li59533/RoadRollerSensor/doc/压路机通讯协议说明.md

# LN 压路机传感器通讯协议说明
V0.0.4

日期：2020.9.7

## 1.采用协议
LN私有协议 + 上报私有协议 
###  1.1 协议格式
**LN协议格式**

```
// head len cmd tlv foot sum
typedef struct
{
    uint8_t head;
    uint16_t len;
    uint16_t inf
    uint8_t cmd;
    uint8_t * payload;
    uint8_t foot;
    uint8_t sum;
}LN_Protocol_t
```
**上报私有协议**
```c
typedef struct
{
    uint8_t head;
    uint8_t type;
    uint16_t len;
    float acc_uppeak;
	float base_frequency;
	float harmonic_peak_0_5;
	float harmonic_peak_1;
	float harmonic_peak_1_5;
	float harmonic_peak_2;
	float harmonic_peak_2_5;
	float harmonic_peak_3;
	float harmonic_peak_4;
	float harmonic_peak_5;
	float harmonic_peak_6;
	float speed_RMS;
	float displace_uppeak;
	float temperature;
	uint8_t power;
    float acc_mean;
	float acc_downpeak;
    float displace_downpeak;
	uint8_t sum;
	uint8_t foot;
}

```

### 1.2协议说明
	**LN 协议**
* head ： 协议头部，为固定标识
* len :从head到sum的长度
* Inf:预留，用于兼容点对点、1对多、ACK等用途
* cmd：当前报文所属命令
* payload：当前cmd所包含的负载内容
* foot: 协议尾部，为固定标识
* sum:校验和，从head到foot
  **上报协议**
* head：协议头部，为固定标识
* type：类型
* len：长度，以下数据的所有长度，从acc_uppeak到displace_downpeak
* acc_uppeak：加速度正峰值，g
* base_frequency：基频，Hz
* harmonic_peak_0_5：0.5次谐波峰值，g
* harmonic_peak_1：1次谐波峰值，g
* harmonic_peak_1_5：1.5次谐波峰值，g
* harmonic_peak_2：2次谐波峰值，g
* harmonic_peak_2_5：2.5次谐波峰值，g
* harmonic_peak_3：3次谐波峰值，g
* harmonic_peak_4：4次谐波峰值，g
* harmonic_peak_5：5次谐波峰值，g
* harmonic_peak_6：6次谐波峰值，g
* speed_RMS：速度有效值，mm/s
* displace_uppeak：位移正峰值，um
* temperature：温度，C
* power：电量
* acc_mean：加速度均值，g
* acc_downpeak：加速度负峰值，g
* displace_downpeak：位移负峰值，um
* sum：校验和，从type到校验和之前
* foot：协议尾部，为固定值
## 2.命令说明
### 2.1 压路机支持命令
|序号|cmd|说明|名称|
|---|---|---|---|
|1|0x01|设置配置参数 请求|CMD_SetConf_Req|
|2|0x02|设置配置参数 应答|CMD_SetConf_Resp|
|3|0x03|获取配置参数 请求|CMD_GetConf_Req|
|4|0x04|获取配置参数 应答|CMD_GetConf_Resp|
|5|0x80|获取软件版本 请求|CMD_GetVersion_Req|
|6|0x81|获取软件版本 应答|CMD_GetVersion_Resp|
|7|0xD0|获取数据 请求|CMD_GetValue_Req|
| | | | |

### 2.2 CMD说明

#### 2.2.1 设置配置参数
**请求**：CMD-> CMD_SetConf_Req (0x01)
**Payload **：TLV
协议如下：

|序号|Tag|Len|Value|说明|
|---|---|---|---|---|
|1|0x44|4||电压与加速度对应关系，float 类型。eg:500mv/g|
|2|0x45|1|0-1|自动上报数据标志，0：停用，1：启用|
|3|0x46|1|0~250|位移频率区间_Low 默认10|
|4|0x47|1|0~250|位移频率区间_High 默认 60|
| | | | ||
**应答**
无

#### 2.2.2 获取配置参数

**请求**：CMD->CMD_GetConf_Req(0x03)
**Payload **：

无

**应答**
**Payload **：TLV
协议如下：

|序号|Tag|Len|Value|说明|
|---|---|---|---|---|
|1|0x44|4||电压与加速度对应关系，float 类型。eg:500mv/g|
|2|0x45|1|0-1|自动上报数据标志，0：停用，1：启用|
|3|0x46|1|0~250|位移频率区间_Low|
|4|0x47|1|0~250|位移频率区间_High|
||||||
#### 2.2.3 获取软件版本
**请求**：CMD->CMD_GetVersion_Req(0x80)
**Payload **：

无

**应答**
**Payload**:

```
typedef struct
{
    uint32_t version;
}Payload_t
```

uint32_t 为小端

0x00010203 为1.2.3版本

#### 2.2.4 获取数据
**请求**：CMD->CMD_GetValue_Req(0xD0)
**Payload **：

无

**应答**
**上报私有协议**:type:0x42
