li59533/RoadRollerSensor/doc/压路机传感器测试报告_20191023.xlsx

测试报告
产品名称 |  | 产品编号
软件版本 | V1.0.0 | 硬件版本
测试人员 | 李阳 | 测试时间 | 2019-10-23
测试内容
序号 | 内容 | 状态 | 说明
1 | 不插振动传感器，上报数据清零，传感器指示灯灭 | 通过 | 数据见附录1
2 | 传感器短路，上报数据清零，传感器指示灯快速闪烁 | 通过 | 数据见附录2
3 | 不插温度传感器，温度显示0，温度指示灯灭 | 通过 | 数据见附录3
4 | 振动台加速峰值1.02g，频率160HZ，速度有效值：7.067mm/s，位移峰值9.996m | 通过 | 数据见附录4
5 | 振动台加速峰值1.02g，频率80HZ，速度有效值：14.134mm/s，位移峰值39.984m | 通过 | 数据见附录5
6 | 振动台加速峰值1.02g，频率40HZ，速度有效值：28.268mm/s，位移峰值159.936m | 通过 | 数据见附录6
7 | 振动台加速峰值1.02g，频率20HZ，速度有效值：56.536mm/s，位移峰值639.744m | 不通过 | 振动台达不到20HZ
8 | 函数发生器1Vpp，频率160HZ，加速度峰值1g，速度有效值6.9286mm/s，位移峰值9.8m | 通过 | 数据见附录7
9 | 函数发生器1Vpp，频率80HZ，加速度峰值1g，速度有效值13.8572mm/s，位移峰值39.2m | 通过 | 数据见附录8
10 | 函数发生器1Vpp，频率40HZ，加速度峰值1g，速度有效值27.7144mm/s，位移峰值156.8m | 通过 | 数据见附录9
11 | 函数发生器1Vpp，频率20HZ，加速度峰值1g，速度有效值55.4288mm/s，位移峰值627.2m | 通过 | 数据见附录10
12 | 函数发生器1Vpp，频率10HZ，加速度峰值1g，速度有效值110.8576mm/s，位移峰值2508.8m | 不通过 | 位移峰值10HZ以下被清零了，数据见附录11
13 | 函数发生器1Vpp，频率5HZ，加速度峰值1g，速度有效值221.7152mm/s，位移峰值10035.2m | 不通过 | 位移峰值10HZ以下被清零了，数据见附录12
14 | 函数发生器1Vpp，频率200HZ，加速度峰值1g，速度有效值5.5428mm/s，速度峰值6.272m |  | 数据见附录14
15
16
17
18
19
测试结论
内容 | 1、信号幅值有10%的衰减 2、位移在10HZ以下，没开矩形窗处理掉了 3、速度有效值与加速度峰值满足对应关系 4、位移峰值在11HZ到199HZ ,基本满足与加速度峰值的对应关系
测试是否通过
