li59533/RoadRollerSensor/Master_firmware/changelog.md

-----------------------
**发布时间：**2020.9.11
**代码地址：**https://github.com/li59533/RoadRollerSensor.git
**版本：**V1.2.0
**说明：**
		1.默认参数：50mv/g
		2.加速度峰值单位：g
		3.速度有效值：mm/s
		4.位移峰值；um

**更新内容：**

_删除：_
		无
_新增：_
		无
_修改：_
		1.均值修改为绝对值均值

-----------------
-----------------------
**发布时间：**2020.9.4
**代码地址：**https://github.com/li59533/RoadRollerSensor.git
**版本：**V1.1.5
**说明：**
		1.默认参数：50mv/g
		2.加速度峰值单位：g
		3.速度有效值：mm/s
		4.位移峰值；um

**更新内容：**

_删除：_
		无
_新增：_
		无
_修改：_
		1.默认dis_freq_low:10 , high:60

-----------------

-----------------------
**发布时间：**2020.9.4
**代码地址：**https://github.com/li59533/RoadRollerSensor.git
**版本：**V1.1.4
**说明：**
		1.默认参数：50mv/g
		2.加速度峰值单位：g
		3.速度有效值：mm/s
		4.位移峰值；um

**更新内容：**

_删除：_
		无
_新增：_
		无
_修改：_
		1.取Ac负峰值、均值
        2.取1~200的最大基频
        3.谐波取区间最大值+-2
        4.位移频率截断可配置
        5.

-----------------
-----------------------
-----------------------
**发布时间：**2020.5.6
**代码地址：**https://github.com/li59533/RoadRollerSensor.git
**版本：**V1.1.2
**说明：**
		1.默认参数：500mv/g
		2.加速度峰值单位：g
		3.速度有效值：mm/s
		4.位移峰值；m

**更新内容：**

_删除：_
		1.删除温度+3操作
_新增：_
		无
_修改：_
		1.默认主动上报模式

-----------------
-----------------------
**发布时间：**2020.4.23
**代码地址：**https://github.com/li59533/RoadRollerSensor.git
**版本：**V1.1.1
**说明：**
		1.默认参数：500mv/g
		2.加速度峰值单位：g
		3.速度有效值：mm/s
		4.位移峰值；m

**更新内容：**

_删除：_
		无
_新增：_
		无
_修改：_
		1.修改fft积分函数

-----------------
-----------------------
**发布时间：**2020.1.2
**代码地址：**https://github.com/li59533/RoadRollerSensor.git
**版本：**V1.1.0
**说明：**
		1.默认参数：500mv/g
		2.加速度峰值单位：g
		3.速度有效值：mm/s
		4.位移峰值；m

**更新内容：**

_删除：_
		无
_新增：_
		1.增加自动上报数据标志位
		2.增加被动请求主句命令
_修改：_
		无

-----------------

-----------------------
**发布时间：**2019.10.23
**代码地址：**https://github.com/li59533/RoadRollerSensor.git
**版本：**V1.0.0
**说明：**
		1.默认参数：500mv/g
		2.加速度峰值单位：g
		3.速度有效值：mm/s
		4.位移峰值；m

**更新内容：**

_删除：_
		无
_新增：_
		无
_修改：_

		1.速度有效值替换速度峰值。但是为mm/s

-----------------

-----------------------
**发布时间：**2019.10.22
**代码地址：**https://github.com/li59533/RoadRollerSensor.git
**版本：**V0.1.1
**说明：**
		1.默认参数：500mv/g
		2.加速度单位：g
		3.速度：m/s
		4.位移；m

**更新内容：**

_删除：_
		无
_新增：_
		1.增加Hanning窗
		2.增加0Hz判断清零
_修改：_

		无

-----------------

-----------------------
**发布时间：**2019.10.17
**代码地址：**https://github.com/li59533/RoadRollerSensor.git
**版本：**V0.1.0
**说明：**

		首次提交。

**更新内容：**

		无

_删除：_
		无
_新增：_
		无
_修改：_

		无

-----------------
