li59533/RoadRollerSensor/doc/压实采集器.pdf

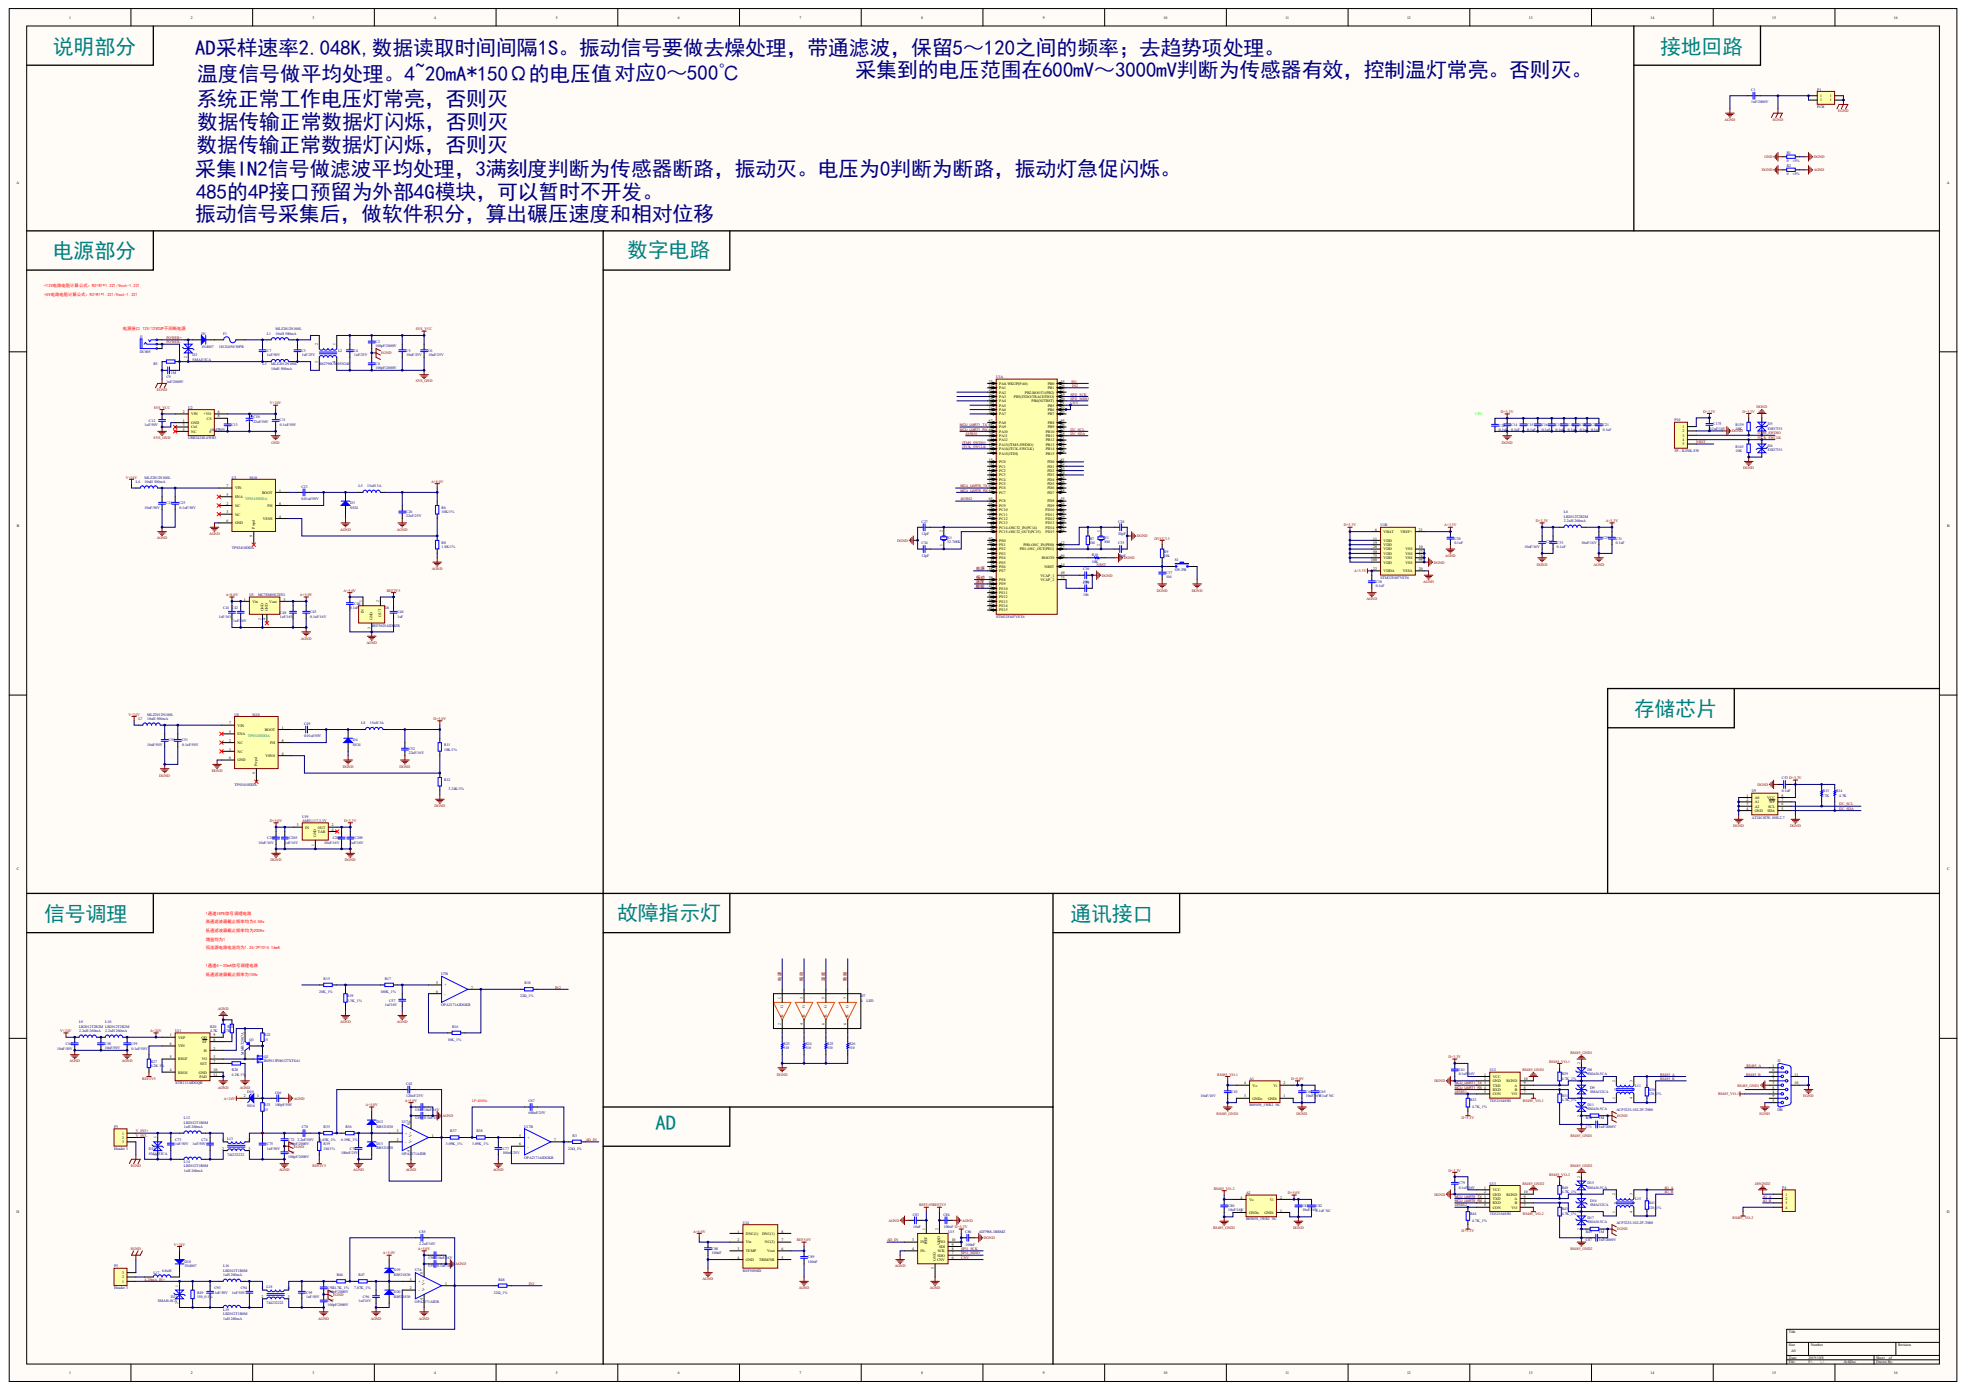
[picture p8: page 1]

GND 6 | AGND

GND 5 CNV 6 SDO 7 SCK 8 SDI 9 VIO 10

Comment | Description | Designator | Footprint | LibRef | Quantity
1nF/ 2000V | 1nF_NPO_10%_2K V_1210, 1nF_X5R_10%_200 0V_1210 | C1, C71, C87 | C 1210_L | Cap | | 3
100pF/ 2000V | 100PF_X5R_10%_ 2000V_1206 | C2, C8 | C 1206_L | Cap | | 2
1uF/ 25V | 1uF_X5R_10%_25 V_0805 | C3, C4 | C 0805_L | Cap | | 2
10uF/ 25V | 10uF_X5R_10%_25 V_1210 | C5, C6 | C 1210_L | Cap | | 2
1uF/ 50V | 1uF_X5R_10%_50 V_0805 | C7, C12 | C 0805_L | Cap | | 2
1nF/ 2000V | 1nF_X5R_10%_200 0V_1206 | C9 | C 1206_L | Cap | | 1
22uF/ 50V | 铝电解电容 8*10.5 | C10 | CAP6.3 | Cap Pol1 | | 1
0.1uF/ 50V | 0.1uF_X5R_10%_5 0V_0603, 0.1uF_X5R_10%_5 0V_0805, 10uF_X5R_10%_50 V_0603 | C11, C25, C51, C59 | C 0603_L | Cap | | 4
10uF/ 50V | 10uF_X5R_10%_50 V_1210 | C13 | C 1210_L | Cap | | 1
0.1uF | 0.1uF_X5R_10%_1 6V_0603, 104_X7R_10%_16 V_0603 | C14, C15, C16, C17, C18, C19, C20, C21, C22, C30, C31, C33, C38, C40, C53 | C 0603_L | Cap | 15
0.01uf/50V | 0.01uF_X5R_10%_ 50V_0603 | C23, C49 | C 0603_L | Cap | | 2
10uF/ 50V | 10uF_X5R_10%_50 V_0603 | C24, C50 | C 0603_L | Cap | | 2
22uF/ 25V | 22uF_X5R_20%_25 V_0805 | C26 | C 0805_L | Cap | | 1
12pF | 12pF_X7R_10%_16 V_0603 | C27, C34 | C 0603_L | Cap | | 2
20pF | 20pF_X7R_10%_16 V_0603 | C28, C35 | C 0603_L | Cap | | 2
10uF/ 16V | 10uF_X5R_10%_16 V_0603 | C29, C32 | C 0603_L | Cap | | 2
100nF | 100nF_X7R_10%_1 6V_0603 | C36, C39, C84, C86, C88, C89 | C 0603_L | Cap | | 6
104 | 104_X7R_10%_16 V_0603 | C37 | C 0603_L | Cap | | 1
1uF/ 16V | 1uF_X5R_10%_16 V_0805 | C41, C42, C48 | C 0805_L | Cap | | 3
0.1uF/ 16V | 0.1uF_X5R_10%_1 6V_0603 | C45, C61, C69, C79, C91 | C 0603_L | Cap | | 5
1uF | 1uF_X5R_10%_16 V_0603 | C46 | C 0603_L | Cap | | 1
22uF/ 16V | 22uF_X5R_10%_16 V_0805 | C52 | C 0805_L | Cap | | 1
1uf/16V | 1UF_X7R_10%_16 V_0603, 1UFF_X7R_10%_5 0V_0603 | C57, C96 | C 0603_L | Cap | | 2
10uF/ 50V | 10uF_X5R_10%_50 V_0805 | C58, C60 | C 0805_L | Cap | | 2
120nF/ 25V | 12nF_X7R_10%_50 V_0603 | C62 | C 0603_L | Cap | | 1
10uF/ 16V | 10uF_X5R_10%_16 V_0805, 贴片电容 0805 | C63, C64, C80, C81, C207, C208 | 0805C | Cap | | 6
0.1uF NC | 0.1uF_X5R_10%_1 6V_0603 | C65, C82 | C 0603_L | CAP | | 2
100pF/ 50V | 0.1uF_X5R_10%_5 0V_0603 | C66 | C 0603_L | Cap | | 1
680nF/ 25V | 680nF_X7R_10%_2 5V_0603 | C67 | C 0603_L | Cap | | 1
10uF/ 16V | 10uF_X5R_10%_16 V_0805 | C68, C90 | C 0805_L | Cap | | 2
2.2uF/ 50V | 2.2uF_NPO_10%_5 0V_0805 | C70 | C 0805_L | Cap | | 1
100pF/ 2000V | 100pF_NPO_10%_ 2KV_1210 | C72, C78, C92, C97 | C 1210_L | Cap | | 4
1nF/ 50V | 1nF_X7R_10%_50 V_0603 | C73, C74, C75, C93, C94, C95 | C 0603_L | Cap | | 6
100nF/ 25V | 100nF_X7R_10%_2 5V_0603, 100nF_X7R_10%_5 0V_0603 | C76, C77 | C 0603_L | Cap | | 2
10uf | 10uF_X7R_10%_16 V_0603 | C83 | C 0603_L | Cap | | 1
2.2uF/ 16V | 2.2uF_X7R_10%_1 6V_0603 | C85 | C 0603_L | Cap | | 1
0.1uF/ 16V | 贴片电容 0603 | C175 | 0603C | Cap | | 1
1uF/ 16V | 贴片电容 0805 | C205, C209 | 0805C | Cap | | 2
1N4007 | 贴片二极管 | D1 | SMA | Diode 1N4007 | | 1
SMAJ13CA | 瞬态抑制二极管 | D2 | SMA | ESD_D | | 1
SS34 | _SMB(DO-214AA) 肖特基二极管 | D3, D4 | SMB | Diode 1N4007 | | 2
ESD7351 | 瞬态抑制二极管 | D5, D6 | SOD-323 | ESD_D | | 2
4 LED 联 | 90 LED ° 导光柱 4PIN 导光柱 型号 LPE4-5-16 | D7 | 4LED | 4 LED 联 | | 1
SMAJ6.5CA | 瞬态抑制二极管 | D8, D11, D15, D17 | SMA | ESD_D | | 4
SMAJ12CA | 瞬态抑制二极管 | D9, D16 | SMA | ESD_D | | 2
SS16 | 肖特基二极管 | D10 | SMA | D Zener | | 1
RB521S30 | 肖特基二极管 | D12, D13, D19, D20 | SOD-523 | DIODE | | 4
SMAJ33CA | 瞬态抑制二极管 | D14 | SMA | ESD_D | | 1
1N4007 | 二极管 | D18 | SMB | Diode 1N4007 | | 1
SMAJ6.0CA | 瞬态抑制二极管 | D21 | SMA | ESD_D | | 1
1812L050/ 30PR | 1812 30V 0.5A 贴片自恢复保险丝 | F1 | FU 1812 | Fuse 2 | | 1
DC005 | Jack SoDC 白 插座 DC005 5.5*2.1MM 3 3P 脚 DIP DC 电源接口 | J1 | DC-005 | Phonejack3 | | 1
DB 公头 | Receptacle Assembly, 9 Position, Right Angle | J2 | DB9/ P_A | D Connector 9 | | 1
MLZ2012N100L | 固定电感器 _20%_MLZ2012N1 _10uH_ 00LT000 | L1, L3, L4, L7 | L 0805 | Inductor | | 4
B82790C0105N240 | EPCOS, 扼流 圈 ,1mH,500mA | L2 | IND0163-B | TRAN | | 1
15uH 3A | _NR6028 6*6 功率电感 | L5, L8 | NR6028 | Inductor | | 2
LB2012T2R2M | 固定电感器 0805 | L6, L9, L10 | L 0805 | Inductor | | 3
ACP3225-102-2P-T000 | TDK, ,4.1uH,1.5A 共模扼流 圈 | L11, L15 | ACP3225 | TRANS1 | | 2
LB2012T1R0M | Taiyo Yuden 1uH 260mA | L12, L14, L16, L19 | L 0805 | Inductor | | 4
744232222 | 共模扼流圈 滤波器 / 2.2k 100MHz 200mA | L13, L18 | 744232222 | TRANS4_2 | | 2
6.8uH | 功率电感 _5.0*5.0*4.0_CKCS 5040-6.8uH/M | L17 | NR5040 | INDUCTOR | | 1
PCB 接地柱 | 接地座黄接线柱 M3M4 侧卧式 PCB 焊 接端子 pcb-2 | P1 | PCB 接地柱 | Header 2X2 | | 1
Header 3 | 插拔式 PCB 接线端 子 KF 2EDGV-3.81mm 直针座 3p | P3, P5 | KF-3.81-3P | Header 3 | | 2
科发接插件 | lZ1R-3.81-4P-140-00A 弯针加插头 | P4 | KF-3.81-4P | Header 4 | | 1
5P - JLINK-SW | Header, 5-Pin | P10 | HDR2.54-LI-5P | Header 5 | | 1
MMBT2907A | 三极管 PNP | Q1 | MMBT2907A | 2N3906 | | 1
BSP613PH6327XT SA1 | P-Channel MOSFET | Q2 | BSP613PH6327XT SA1 | MOSFET-P | | 1
0 ± 5% | 0 ± 5%_0603 | R1, R2 | 1206R | Res2 | | 2
Ω 22 _1% | Ω 22 _1%_0603 | R3, R18, R48 | 0603R | Res2 | | 3
1M | 1M_5%_0805 | R5, R34, R45 | 0805R | Res2 | | 3
10K/ 1% | 10K/ 1%_0603 | R6, R11 | 0603R | Res | | 2
1M | Resistor | R7 | 0603R | Res2 | | 1
1.8K/ 1% | 1.8K/ 1%_0603 | R8 | 0603R | Res | | 1
10k | 10K_1%_0603, Resistor, 贴片电阻 0603 | R9, R10, R139, R145 | 0603R | Res1, Res2 | | 4
3.24K/ 1% | 3.24K/ 1%_0603 | R12 | 0603R | Res | | 1
4.7k | 4.7k_1%_0603 | R13, R14 | 0603R | Res1 | | 2
20K_1% | 20K_1%_0603 | R15 | 0603R | Res2 | | 1
10K_1% | 10K_1%_0603 | R16 | 0603R | Res2 | | 1
100K_1% | 100K_1%_0603 | R17 | 0603R | Res2 | | 1
3.3K_1% | 3.3K_1%_0603 | R19 | 0603R | Res2 | | 1
4.7K | 4.7K 1%_0402 | R20, R21 | 0402R | Res2 | | 2
15 | 15 Ω 1%_0603 | R22, R33 | 0603R | Res2 | | 2
510 | 510_1%_0603 | R23, R24, R25, R26 | 0603R | Res Semi | | 4
6.2K 1% | 6.2K 1%1%_0603, 6.2K 1%_0603 | R27, R28 | 0402R | Res2 | | 2
4.7K_1% | 4.7K_1%_0603 | R29, R31, R32, R40, R43, R44 | 0603R | 电阻 1/ 4 | | 6
120_1% | 120_1%_0603 | R30, R41 | 0603R | Res_0603 | | 2
8.45K_1% | 8.45K_1%_0603 | R35 | 0603R | Res2 | | 1
6.19K_1% | 6.19K_1%_0603 | R36 | 0603R | Res2 | | 1
3.09K_1% | 3.09K_1%_0603 | R37, R38 | 0603R | Res2 | | 2
1M/ 1% | 1M 1%_0603 | R39 | 0603R | Res | | 1
14.7K_1% | 14.7K_1%_0603 | R46 | 0603R | Res2 | | 1
7.87K_1% | 7.87K_1%_0603 | R47 | 0603R | Res2 | | 1
150_0.1% | 150_0.1%_0603 | R49 | 0603R | Res | | 1
SW-PB | Switch | S1 | 白色轻触 3*6*5mm 开关 | SW-PB | | 1
STM32F407VET6 | ARM Cortex-M4 32-bit MCU+FPU, 210 DMIPS, 512 kB Flash, 192 kB Internal RAM, 82 I/Os, 100-pin LQFP, -40 to 85 degC, Tray | U1 | STM-LQFP100_N | STM32F407VET6 | | 1
URB2424S-6WR3 | 金升阳 DC-DC 隔离 模块 24V-24V 3W | U2 | URB2424S-6WR3 | WRB2424S-3WR2 | | 1
TPS5410DDA | TI,DC-DC 电源芯片 | U3, U8 | SOIC-8 | TPS5430DDA | | 2
MC78M05CDTG | ST, ,9V 5V 电源转换芯 片 转 | U5 | TO252 | 7805 | | 1
REF3025AIDBZR | 贴片集成电路 | U6 | SOT23-3N | R | | 1
OPA2171AIDR | 贴片集成电路 | U7, U17 | SO-8 | OP262 | | 2
AT24C02W-10SI-2.7 | 存储芯片 SOP8 | U9 | 24c02 | AT24C32 | | 1
XTR111AIDGQR | 4-20mA 转换芯片 | U11 | XTR111 | XTR111AIDGQR | | 1
TD321S485H | 200Kbps 金升阳 485 隔离模块 | U12, U13 | TD321S485H | TD321S485H | | 2
REF5050ID | TI, 基准芯片 SOIC-8 | U14 | REF5050ID | REF5050ID | | 1
AD7988-1BRMZ | 模数转换器 - ADC | U15 | MSOP10_N | AD7988 | | 1
AMS1117-3.3V | 1A 线性稳压器 3.3V | U19 | SOT223_N | LM1117MP-3.3 | | 1
32.768K | Crystal Oscillator | X1 | OSC 3215-2P | XTAL | | 1
8M | SMD-5032_2P 8M 20Y1 | | OSC 5032-2P | XTAL | | 1
