li59533/RoadRollerSensor/code/stm32F4xx/stm32f4xx/projects/stm32f4xx/source/application/hal_task/hal_task.h

/**
 **************************************************************************************************
 * @file        hal_task.h
 * @author
 * @version    v0.1.0
 * @date        
 * @brief
 **************************************************************************************************
 * @attention
 *
 **************************************************************************************************
 */
#ifndef _HAL_TASK_H_
#define _HAL_TASK_H_

/**
 * @addtogroup    XXX 
 * @{ 
 */
#include "osal.h"
/**
 * @addtogroup    hal_task_Modules 
 * @{  
 */

/**
 * @defgroup      hal_task_Exported_Macros 
 * @{  
 */
#define HAL_TASK_TIMEOUT_EVENT      0x0001
#define HAL_TASK_LED_BLINK_EVENT	0x0002
#define HAL_TASK_ADC_CALC_EVENT		0x0004
/**
 * @}
 */

/**
 * @defgroup      hal_task_Exported_Constants
 * @{  
 */

/**
 * @}
 */

/**
 * @defgroup      hal_task_Exported_Types 
 * @{  
 */

/**
 * @}
 */

/**
 * @defgroup      hal_task_Exported_Variables 
 * @{  
 */
extern uint8_t g_HalTask_Id;
/**
 * @}
 */

/**
 * @defgroup      hal_task_Exported_Functions 
 * @{  
 */
void HalTask_Init(uint8_t taskId);
osal_event_t HalTask_Process(uint8_t taskid,osal_event_t events);
void HalTask_Send_Event(osal_event_t events);
void HalTask_Clear_Event(osal_event_t events);

/**
 * @}
 */

/**
 * @}
 */

/**
 * @}
 */
#endif
