li59533/RoadRollerSensor/code/stm32F4xx/stm32f4xx/projects/stm32f4xx/source/fml/system/system_param.h

/**
 **************************************************************************************************
 * @file        system_param.h
 * @author
 * @version
 * @date        
 * @brief
 **************************************************************************************************
 * @attention
 *
 **************************************************************************************************
 */
#ifndef _SYSTEM_PARAM_H_
#define _SYSTEM_PARAM_H_

/**
 * @addtogroup    XXX 
 * @{ 
 */
#include "self_def.h"
/**
 * @addtogroup    system_param_Modules 
 * @{  
 */

/**
 * @defgroup      system_param_Exported_Macros 
 * @{  
 */
#define SYS_PARAM_SAVE_FLASH_FIRSTHEAD   		0x080C0000
#define SYS_PARAM_SAVE_FLASH_SECONDHEAD			0X080E0000

#define SYSTEMPARAM_CONFIG     0



/**
 * @}
 */

/**
 * @defgroup      system_param_Exported_Constants
 * @{  
 */

/**
 * @}
 */

/**
 * @defgroup      system_param_Exported_Types 
 * @{  
 */
#pragma pack(1)
typedef struct
{
	float AD7988_VolACC_p;
	uint8_t Auto_Report_Flag;
	uint16_t integ_freq_min ; 
	uint16_t integ_freq_max ; 
    uint16_t crc;           /*!< 所有的参数结构体必须按字节对其。且最后一个必须包
                                 含一个uint16_t类型的数据，该数据用于内部存储时的
                                 crc校验和存储，用户在保存参数时不用关心该值数值。*/
}SystemParam_Config_t;
#pragma pack()
/**
 * @}
 */

/**
 * @defgroup      system_param_Exported_Variables 
 * @{  
 */
extern SystemParam_Config_t g_SystemParam_Config;
/**
 * @}
 */

/**
 * @defgroup      system_param_Exported_Functions 
 * @{  
 */
void SystemParam_Init(void);

int16_t SystemParam_Read(uint8_t handle);

void SystemParam_Save(void);

void SystemParam_Reset(uint8_t handle);

void SystemParam_Apply(uint8_t handle);
/**
 * @}
 */

/**
 * @}
 */

/**
 * @}
 */
#endif
