li59533/RoadRollerSensor/code/stm32F4xx/stm32f4xx/projects/stm32f4xx/source/fml/temperatue_4_20mV/t_4_20mv.h

/**
 **************************************************************************************************
 * @file        t_4_20mv.h
 * @author
 * @version    v0.1.0
 * @date        
 * @brief
 **************************************************************************************************
 * @attention
 *
 **************************************************************************************************
 */
#ifndef _T_4_20MV_H_
#define _T_4_20MV_H_

/**
 * @addtogroup    XXX 
 * @{ 
 */

/**
 * @addtogroup    t_4_20mv_Modules 
 * @{  
 */

/**
 * @defgroup      t_4_20mv_Exported_Macros 
 * @{  
 */

/**
 * @}
 */

/**
 * @defgroup      t_4_20mv_Exported_Constants
 * @{  
 */

/**
 * @}
 */
 
/**
 * @defgroup      t_4_20mv_Exported_Types 
 * @{  
 */

/**
 * @}
 */

/**
 * @defgroup      t_4_20mv_Exported_Variables 
 * @{  
 */

/**
 * @}
 */

/**
 * @defgroup      t_4_20mv_Exported_Functions 
 * @{  
 */
void T_4_20mv_CalcProcess(void);
float T_4_20mv_GetTemperatureValue(void);
/**
 * @}
 */

/**
 * @}
 */

/**
 * @}
 */
#endif
