li59533/RoadRollerSensor/code/stm32F4xx/stm32f4xx/components/bsp/bsp_led.h

/**
 **************************************************************************************************
 * @file        BSP_LED.h
 * @author
 * @version
 * @date        
 * @brief
 **************************************************************************************************
 * @attention
 *
 **************************************************************************************************
 */
#ifndef _BSP_LED_H_
#define _BSP_LED_H_

/**
 * @addtogroup    XXX 
 * @{ 
 */
#include "self_def.h"
/**
 * @addtogroup    BSP_LED_Modules 
 * @{  
 */

/**
 * @defgroup      BSP_LED_Exported_Macros 
 * @{  
 */
#define BSP_LED1        0
#define BSP_LED2        1
#define BSP_LED3        2

#define BSP_LED_POWER		0
#define BSP_LED_VIBRATOR	1
#define BSP_LED_TEMPERATURE	2
#define BSP_LED_DATA		3


#define BSP_LEDCOUNT    4

#define BSP_LED_BLINK_ENABLE   TRUE
/**
 * @}
 */

/**
 * @defgroup      BSP_LED_Exported_Constants
 * @{  
 */

/**
 * @}
 */

/**
 * @defgroup      BSP_LED_Exported_Types 
 * @{  
 */

/**
 * @}
 */

/**
 * @defgroup      BSP_LED_Exported_Variables 
 * @{  
 */

/**
 * @}
 */

/**
 * @defgroup      BSP_LED_Exported_Functions 
 * @{  
 */
void BSP_LED_Init(void);
void BSP_LED_Open(uint8_t LEDx);
void BSP_LED_Close(uint8_t LEDx);
void BSP_LED_Toggle(uint8_t LEDx);
void BSP_LED_Blink(uint8_t BSP_LEDx, uint8_t numBlinks, uint8_t percent, uint16_t period);
void BSP_LED_Update(void);
/**
 * @}
 */

/**
 * @}
 */

/**
 * @}
 */
#endif
