li59533/RoadRollerSensor/(commit log)

2019-09-24 增加BSP
    增加SPI_BSP
    增加ADC_BSP
    新建AD7988_1文件夹
2019-09-27 add bsp
    1.led_bsp
    2.exti_bsp
    3.iic_bsp
2019-10-08 update
    1.add uart6
2019-10-10 还缺计算
2019-10-11 基本可用版本
2019-10-16 添加flash存储
2019-10-16 添加报文版本
2019-10-17 release版本V0.1.0
    1.发布release版本:V0.1.0
    2.增加配置功能
    3.增加版本号
    4.提交协议文档
    5.添加发布hex
2019-10-22 release版本V0.1.1
    1.增加hanning窗
    2.增加0HZ判断
2019-10-23 master版本V1.0.0
    1.计算速度有效值替换速度峰值，单位：mm/s
2019-10-24 上传测试报告
    [压路机传感器测试报告_20191023.xlsx]
2019-10-25 优化配置工具
2020-01-02 V1.1.0
    **更新内容：**
    _删除：_
    无
    _新增：_
    1.增加自动上报数据标志位
    2.增加被动请求主句命令
    _修改：_
    无
2020-03-13 备份提交
    备份提交
2020-04-23 V1.1.1
    1.修改fft积分函数
    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
2020-06-17 V1.1.2
    1.删除温度+3操作
    1.默认主动上报模式
    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
2020-08-31 V1.1.3
    1.时采时算
    2.
2020-09-04 V1.1.4
    1.取Ac负峰值、均值
    2.取1~200的最大基频
    3.谐波取区间最大值+-2
    4.位移频率截断可配置
    5.
2020-09-04 V1.1.5
    1.默认dis_freq_low:10 , high:60
2020-09-11 V1.2.0
    1.均值修改为绝对值均值
